michalmonday/WiFi-Locator/central_unit/README.md

Central unit receives RSSI values from nodes and calculates/displays direction of the access point. (The same access point is used for being located and actually collecting the RSSI values.)

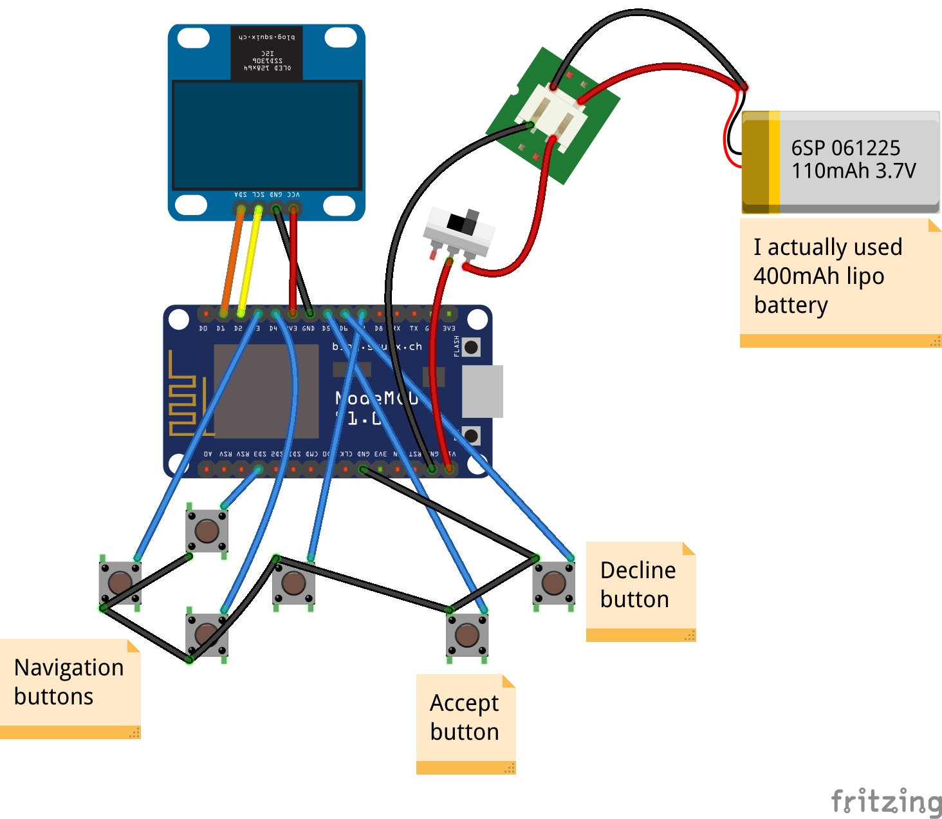
[picture p9: pics/central_unit_schematic.png]


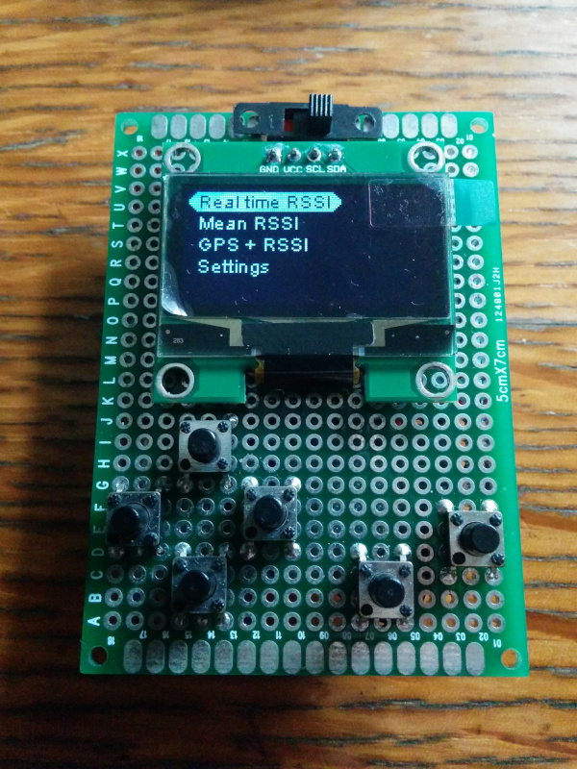
[picture p10: pics/central_unit_menu.jpg]


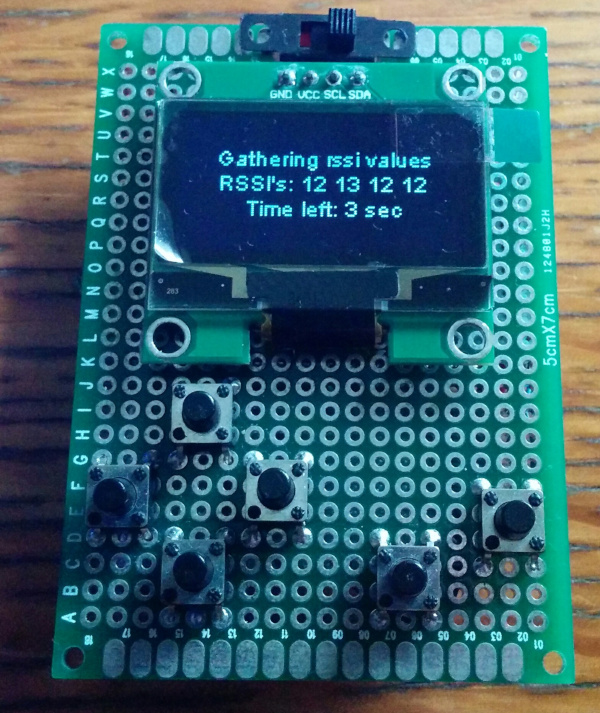
[picture p11: pics/central_unit_mean_gathering.jpg]


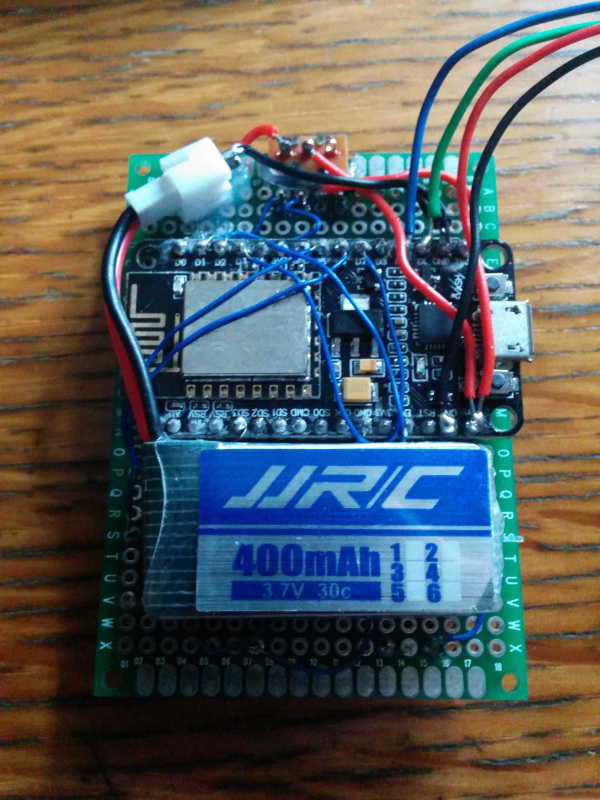
[picture p12: pics/central_unit_back.jpg]
