michalmonday/WiFi-Locator/pics/central_unit_no_data.jpg

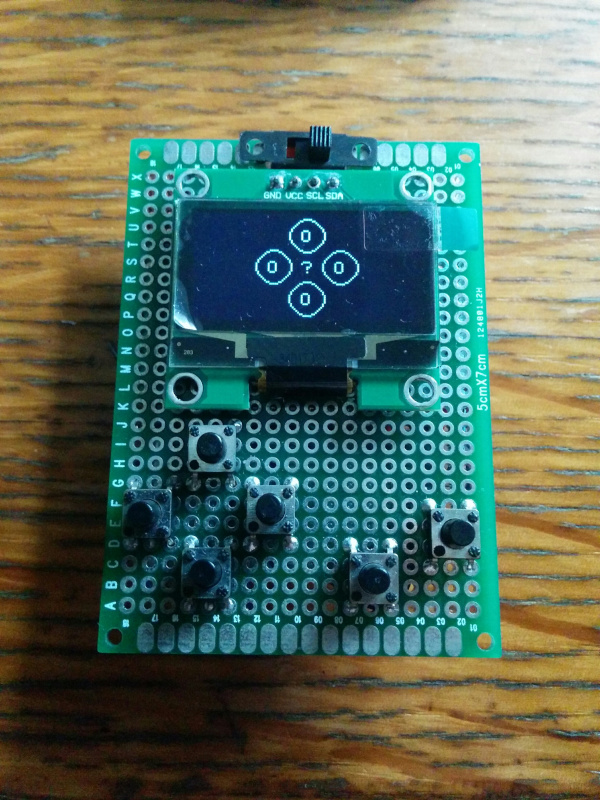
pics/central_unit_no_data.jpg
