michalmonday/WiFi-Locator/pics/IMG_20190103_133731.jpg

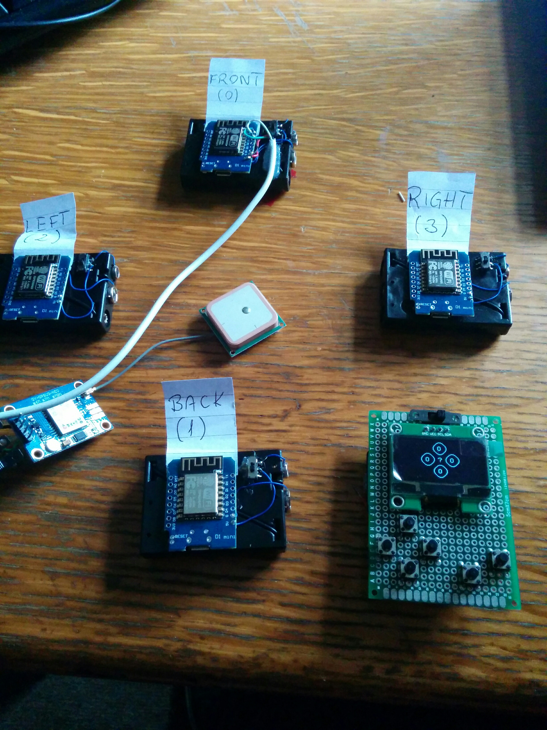
pics/IMG_20190103_133731.jpg
