michalmonday/WiFi-Locator/pics/test_front.jpg

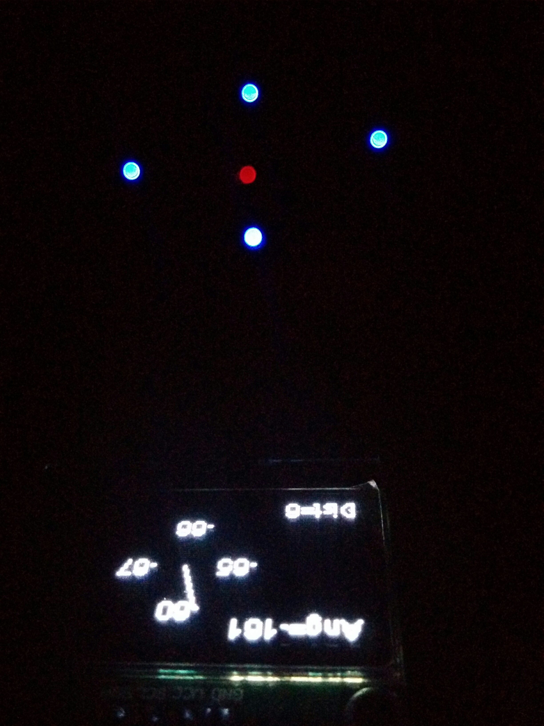
pics/test_front.jpg
