michalmonday/WiFi-Locator/pics/test_left.jpg

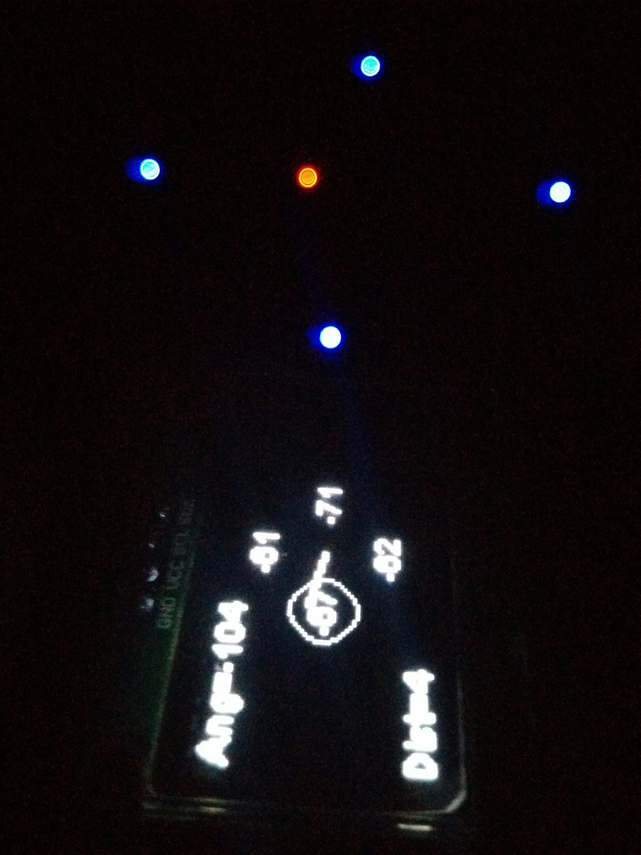
pics/test_left.jpg
