michalmonday/WiFi-Locator/pics/test_right.jpg

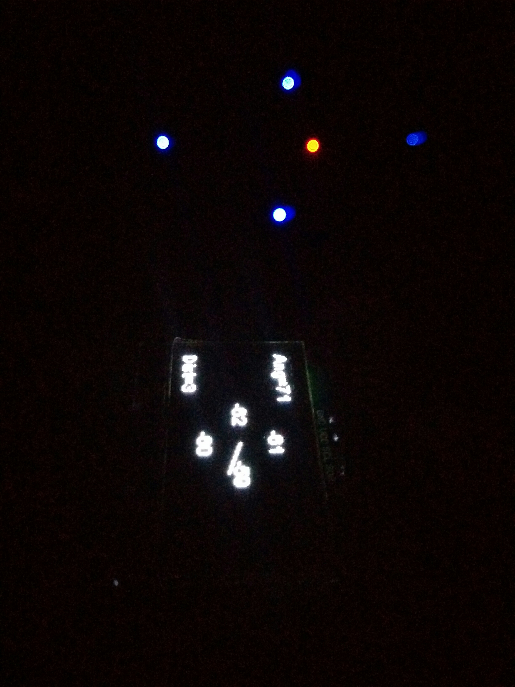
pics/test_right.jpg
