michalmonday/WiFi-Locator/(threads)

Thread 1 (2019-07-19):

Display does not display anything

GlOwl, 2019-07-19:
I cabled the central unit up as in your diagram and have everything compiling flawlessly but even after a minute or so the display does not start to show anything.

Do I have to have all 4 wmos chips to connect before anything is shown?

michalmonday, 2019-07-19:
The intro and menu should be shown regardless of the nodes, so something definitely went wrong.

Is there any output in the serial monitor when the NodeMCU is resetted while being connected through USB?

My first thought is SPIFFS, it is used to load settings (including brightness). Maybe SPIFFS isn't initialized properly, did you pick a `Flash Size` setting with some memory allocated for it?

Possibly it would be a good idea to temporarily uncomment the `//SPIFFS.format();` line in `central_unit.ino` (not sure whether it will help).

Also, just under that line there is the folowing part:
```cpp
  //Serial.println("Before settings load");
  settings.Load();
  //Serial.println("After settings load");
```
Uncommenting these 2 `Serial.println`'s before testing it again would also be a good idea (possibly it will crash within `settings.Load` resulting in the 2nd `Serial.println` not being shown). `settings.Load` is where the SPIFFS is used to read settings, also that's where the brightness of the display is being set (which ranges between 0-255 as far as I remember). The display goes near-black if the brightness is less than 40, but if "Brightness" setting is unavailable (e.g. due to "`SPIFFS.format()` being called) then the brightness should be automatically set to 60 (so I doubt it is the source of the problem).

Another potential thing that could go wrong is this line in `central_unit.ino`:
`rssi_gatherer.Init("locator_ap", "12345678");`
The password (12345678), must contain at least 8 chars. (I doubt it would lead to menu/intro not being shown on display though).

If the source of the problem won't be found (e.g. if the output in the serial monitor will not be sufficient) I'll update the code with more debug lines.
